MircoM99/electronics/Avionics/components.md

## Components

* Main Board
  * MCU: STM32F411
  * IMU: MPU6050
  * GPS: MS8607
  * TEMP: TM4411, per serbatoio, NBPTCO-176 per altre misurazioni
  * PRS: PT5402 e PT5423
  * SPINTA: FC2311-0000-2000-L
  * PESO SERBATORIO: Cella di carico
  * EEPROM: STM M24M01-DFMN6TP
  * SD: 
  
* BMS
  * 18650 Li Ion
  * 24V: Boost Converter con LM3488
  * 12V: Boost Converter con LM3488
  * 5V: Regolatore lineare con AMS1117CD-5.0
  * 3.3V: Regolatore lineare con AMS1117CD-3.3

* RF 
  * RADIO: LORA SX1278
