MircoM99/electronics/Test Stand/Documents/Components Selection.xlsx

Components Selection
Microcontoller | Qnt | CPU | CPU Speed | RAM | Flash | Power Consumtion | Price (Development Board) | Comments
Arduino Uno | 0 | 8 Bit ATmega328P | 16 Mhz | 2 KB | 32 KB + 1 KB EEPROM | ~ 50 mA | €25.00
Arduino Due | 0 | 32 Bit ATSAM3X8E | 84 Mhz | 96 KB | 512 KB | ~ 100 mA | €40.00
ESP8266 | 0 | 32 Bit Xtensa L106 | 80 - 160 Mhz | 160 KB | ~4 MB (Not on Chip) | 10 ~ 20 mA (Wifi OFF) | €16.00
ESP32 | 3 | 32 Bit Xtensa dual-core LX6 | 160 - 240 Mhz | 520 KB | 4 MB | 30 mA ~ 68 mA | €17.00
Teensy 3.2 | 0 | 32 Bit ARM Cortex M4 | 72 Mhz | 64 KB | 256 KB | ~ 40 mA | €17.00 |  | https://www.pjrc.com/teensy/techspecs.html
Teensy 3.5 | 0 | 32 Bit ARM Cortex M4F | 120 Mhz | 256 KB | 512 KB | ~ 50 mA | €20.50 | SD card holder on board | https://www.pjrc.com/teensy/techspecs.html
Teensy 3.6 | 0 | 32 Bit ARM Cortex M4F | 180 Mhz | 256 KB | 1024 KB | ~ 70 mA | €25.00 | SD card holder on board | https://www.pjrc.com/teensy/techspecs.html
Teensy 4.0 | 0 | 32 Bit ARM Cortex M7 | 600 Mhz | 1 MB | 2 MB | ~ 100 mA | €17.00 |  | https://www.pjrc.com/store/teensy40.html
Teensy 4.1 | 0 | 32 Bit ARM Cortex M7 | 600 Mhz | 1 MB | 8 MB | ~ 100 mA | €22.00 | SD card holder on board | https://www.pjrc.com/store/teensy41.html
Total n. of components | 3
Subprice | €51.00
ADC | Qnt | Bit Resolution | Sampling Speed | Interface | Number of Channel | Operating Voltage | Price (Adafruit) | Comments
ADS1115 | 1 | 16 Bit | 860 Hz | I2C | 4 Channels | 2-5V | €13.00 | 16x Internal PGA, Sampling speed is Hz/N.ofChannels | https://www.adafruit.com/product/1085
ADS1015 | 1 | 12 Bit | 3.3 kHz | I2C | 4 Channels | 2-5V | €8.50 | 16x Internal PGA | https://www.adafruit.com/product/1083
Total n. of components | 2
Subprice | €21.50
Temperature Chip Amplifier | Qnt. | Temperature Sensor | Sampling Speed | Interface | Number of Channel | Operating Voltage | Price (Adafruit) | Comments
MAX31865 | 0 | Platinum RTDs - PT100, PT1000 | ~ 40 Hz | SPI | 1 Channel | 3.3-5V | €12.50 | Internal 15 Bit ADC | https://www.adafruit.com/product/3328
MAX31855 | 0 | Type K - Thermocouple | ~ 14 Hz | SPI | 1 Channel | 3.3-5V | €12.50 | Internal 14 Bit ADC, No linearization or filtering | https://www.adafruit.com/product/269
MAX31850K | 0 | Type K - Thermocouple | ~ 14 Hz | 1-Wire | 1 Channel | 3.3-5V | €12.50 | Internal 14 Bit ADC, No linearization or filtering, 1 -Wire | https://www.adafruit.com/product/1727
MAX31856 | 5 | All Thermocouple | ~ 12.5 Hz | SPI | 1 Channel | 3.3-5V | €15.00 | Internal 19 Bit ADC | https://www.adafruit.com/product/3263
Total n. of components | 5
Subprice | €75.00
Instrument Amplifier | Qnt | Gain Range | CMRR | Noise | Power Consumption | Operating Voltage | ~ Price (RS Components) (Units) | Comments
INA 826 | 0 | 1-1000 | 120 dB (Min) | 0.52 µVpp | 200 µA | ± 3 to 36V | €2.45 | Not avaliable as THT | https://www.ti.com/product/INA826#product-details##params
INA 333 | 0 | 1-1000 | 100 dB (Min) | 1 µVpp | 50 µA | ± 1.8 to 5.5V | €4.45 | Not avaliable as THT | https://www.ti.com/product/INA333#product-details##params
AD 620 | 0 | 1-10000 | 100 dB (Min) | 0.28 µVpp | 1mA | ± 2.3 to 18V | €10.00 | Not single supply?? | https://www.analog.com/en/products/ad620.html#product-overview
INA 131 | 0 | Fixed Gain of 100 | 110 dB (Min) | 0.4 µVpp | 3mA | ± 2.5 to 18V | €10.00 |  | https://www.ti.com/product/INA131#product-details##params
INA 122P | 1 | 5-10000 | 83 dB (Min) | 2 µVpp | 60 µA | ± 2.2 to 36V | €6.00 |  | https://www.ti.com/product/INA122
Total n. of components | 1
Subprice | €6.00
Pressure Sensor | Qnt | Connector | Max Pressure | Output | Fluid Temperature | Operating Voltage | Price (IFM) | Comments
PT5502 | 0 | M12 | 100 bar | 4-20 mA | -40 to 125 °C | 8-32 DC | €109.20 |  | https://www.ifm.com/it/it/product/PT5502
PT5702 | 0 | DEUTSCH (DT04-3P) | 100 bar | 4-20 mA | -40 to 125 °C | 8-32 DC | €109.20 |  | https://www.ifm.com/it/it/product/PT5702
PT5602 | 0 | AMP-Superseal | 100 bar | 4-20 mA | -40 to 125 °C | 8-32 DC | €109.20 |  | https://www.ifm.com/it/it/product/PT5602
PT5002 | 0 | A DIN (EN17501-803-A) | 100 bar | 4-20 mA | -40 to 125 °C | 8-36 DC | €101.30 |  | https://www.ifm.com/it/it/product/PT5002
PU8502 | 0 | M12 | 100 bar | 0.5-4.5V | -40 to 125 °C | 8-32 DC | €109.20 |  | https://www.ifm.com/it/it/product/PU8502
PU8702 | 0 | DEUTSCH (DT04-3P) | 100 bar | 0.5-4.5V | -40 to 125 °C | 8-32 DC | €109.20 |  | https://www.ifm.com/it/it/product/PU8702
PU8523 | 0 | M12 | 60 bar | 0.5-4.5V | -40 to 125 °C | 8-32 DC | €109.20 |  | https://www.ifm.com/it/it/product/PU8523
PT5023 | 0 | A DIN (EN17501-803-A) | 60 bar | 4-20 mA | -40 to 125 °C | 8-36 DC | €101.30 |  | https://www.ifm.com/it/it/product/PT5023
PT5423 | 2 | M12 | 60 bar | 4-20 mA | -40 to 125 °C | 8-36 DC | €101.30 |  | https://www.ifm.com/it/it/product/PT5423
Total n. of components | 2
Subprice | €0.00
Temperature Sensor | Qnt
Thermocouples |  | Sensor Dimension | Operating Temperature |  | Cable Lenght | N of Wires | Price
Termocoppia a fascetta | 0 |  | -100 a 400 | K |  |  | €22.00 |  | https://www.tcdirect.it/Default.aspx?level=2&department_id=180/26
Termocoppia in fibra di vetro | 0 |  | 400 | K |  |  | €10.00 |  | https://www.tcdirect.it/Default.aspx?level=2&department_id=180/20
Termocoppia incollabile | 0 |  | -30 a 220 | K |  |  | €37.00 |  | https://www.tcdirect.it/Default.aspx?level=2&department_id=180/24
Termocoppia adesiva | 0 |  | -50 a 250 | K |  |  | €8.00 |  | https://www.tcdirect.it/Default.aspx?level=2&department_id=180/22
Termocoppia piccola diametro | 0 |  | -100 a 800 | K |  |  | €40.00 |  | https://www.tcdirect.it/Default.aspx?level=2&department_id=200/1
Adafruit Thermocouple | 0 | 2mm x 20mm | 500 °C | K | 1m | 2 Wire | €8.50 |  | https://www.adafruit.com/product/3245
Termocoppia RS Pro | 0 | 5mm x 5mm | 750 °C | K | 2.5m | 2 Wire | €30.00 |  | https://it.rs-online.com/web/p/termocoppie/3342622/
TC Direct 402-718 | 0 | 12mm x 20mm | -250 a 300°C | T | 2m | 2 Wire | €81.00 | Termocoppia classe 1 da incollare | https://www.tcdirect.it/Default.aspx?level=2&department_id=180/25
M12JSS-M3-U-200-E | 5 | 3mm x 200 mm | 520 °C | J | NA |  | €50.00 | With M8x1 Mounting Threads and M12 Connector | https://www.omega.com/en-us/sensors-and-sensing-equipment/temperature/sensors/temperature-probes/probes-with-integral-connector/p/M12probes
Pt100
Adafruit Platinum RTD | 0 | 4mm x 30mm | -200 a 550 °C |  | 1 m | 3 Wire | €10.00 | ±0.5° C accuracy (To 85°C) | https://www.adafruit.com/product/3290
IFM TS2451 | 0 | 6mm x 50mm | -100 a 600 °C |  | 2m |  | €90.00 | M12 Connector | https://www.ifm.com/it/it/product/TS2451
Total n. of components | 5
Subprice | €250.00 |  |  |  |  |  |  |  | https://it.omega.com/pptst/PR-10.html
Cable Options | Qnt | Type of Cable | Connector | Wires | Lenght |  | Price
Omega M12 Thermocouple Cable | 1 | Stripped Thermocouple Wire | M12 | 2 |  |  | €40.00 | Compensated Thermocouple Cable, Sockets and Pins | https://it.omega.com/pptst/M12CM.html
EVS024 | 1 | Right Angle M12 Cable | M12 | 4 | 5m |  | €14.50 |  | https://www.ifm.com/it/it/product/EVS024
Total n. of components | 2
Subprice | €54.50
Load Cell | Qnt | Cell Type | Capacity |  | Rated Output | Excitation Voltage | Price | Comments
Cella di carico Tedea Huntleigh | 0 | Compressione - Single point | 100 kg |  | 2mV/V | 15 V (Max) | €156.00 |  | https://it.rs-online.com/web/p/celle-di-carico/4438229/
Cella di carico Phidgets | 0 | Compressione - S Type | 100 kg |  | NA | 5-18V | €68.00 | https://www.phidgets.com/?tier=3&catid=9&pcid=7&prodid=229 | https://www.robot-italy.com/it/3138-s-type-load-cell-0-100kg-czl301c.html
Cella di carico TE connectivity | 1 | Compressione - Button | 250 lb |  | 20mV/V | 2-10V | €114.87 |  | https://www.digikey.it/product-detail/it/te-connectivity-measurement-specialties/FC2311-0000-0250-L/MSP6952-ND/809398
Total n. of components | 1
Subprice | €114.87
Barometer/Altimeter | Qnt | Breakout Type | Interface |  | Operating Voltage |  | Price
BMP 280 | 1 | Bosch BMP280 Adafruit | I2C or SPI |  | 3.3/5 V |  | €10.00 |  | https://www.adafruit.com/product/2651
Total n. of components | 1
Subprice | €10.00
Total n. of Components | 22
Total Price | €582.87
