MircoM99/electronics/Test Stand/Documents/README.md

# Documentation links

Qui sono disponibili i link alla documentazione più rilevante riguardo i componenti e i sensori selezionati.  
Nella cartella `\Datasheet PDF` sono presenti i principali datasheet in formato PDF.

## Adafruit HUZZAH32
- [Adafruit Shop](https://www.adafruit.com/product/3405)
- [Adafruit Overview](https://learn.adafruit.com/adafruit-huzzah32-esp32-feather)
- [ESP32 Datasheet](https://www.espressif.com/sites/default/files/documentation/esp32_datasheet_en.pdf)
- [ESP32 WROOM32 Datasheet](https://www.espressif.com/sites/default/files/documentation/esp32-wroom-32_datasheet_en.pdf)
- [ESP32 Technical Manual](https://espressif.com/sites/default/files/documentation/esp32_technical_reference_manual_en.pdf)

  - [Adafruit HUZZAH32 Schematics](https://cdn-learn.adafruit.com/assets/assets/000/041/630/original/feather_schem.png?1494449413)
  - [Adafruit HUZZAH32 PCB Layout](https://cdn-learn.adafruit.com/assets/assets/000/041/629/original/feather_fabprint.png?1494449394)

## Adafruit ADS1115 - ADS1015
- [Adafruit ADS1115 Shop](https://www.adafruit.com/product/1085)
- [Adafruit ADS1015 Shop](https://www.adafruit.com/product/1083)
- [Adafruit ADS1115/ADS1015 Overview](https://learn.adafruit.com/adafruit-4-channel-adc-breakouts/overview)
- [ADS1115 Datasheet](https://cdn-shop.adafruit.com/datasheets/ads1115.pdf)
- [ADS1015 Datasheet](https://cdn-shop.adafruit.com/datasheets/ads1015.pdf)

  - [ADS1115/ADS1015 Schematics](https://cdn-learn.adafruit.com/assets/assets/000/036/145/original/sensors_schem.png?1475541078)
  - [ADS1115/ADS1015 PCB Layout](https://cdn-learn.adafruit.com/assets/assets/000/036/146/original/sensors_fabprint.png?1475541096)
  
## Adafruit MAX31856
- [Adafruit Shop](https://www.adafruit.com/product/3263)
- [Adafruit Overview](https://learn.adafruit.com/adafruit-max31856-thermocouple-amplifier)
- [MAX31856 Datasheet](https://cdn-learn.adafruit.com/assets/assets/000/035/948/original/MAX31856.pdf)

  - [Adafruit MAX31856 Schematics](https://cdn-learn.adafruit.com/assets/assets/000/035/946/original/sensors_schem.png?1474583748)
  - [Adafruit MAX31856 PCB Layout](https://cdn-learn.adafruit.com/assets/assets/000/035/947/original/sensors_fab.png?1474584073)
  
## Adafruit MicroSD Breakout
- [Adafruit Shop](https://www.adafruit.com/product/254)
- [Adafruit Overview](https://learn.adafruit.com/adafruit-micro-sd-breakout-board-card-tutorial)

  - [Adafruit MicroSD Breakout Schematic](https://cdn-learn.adafruit.com/assets/assets/000/035/635/original/adafruit_products_schem.png?1473451805)
  - [Adafruit MicroSD Breakout PCB Layout](https://cdn-learn.adafruit.com/assets/assets/000/035/634/original/adafruit_products_fabprint.png?1473451788)
  
## INA 122
- [INA 122 Overview](https://www.ti.com/product/INA122)
- [INA 122 Datasheet](https://www.ti.com/lit/ds/symlink/ina122.pdf)

## IFM PT5423 Pressure Sensor
- [IFM PT5423 Shop](https://www.ifm.com/it/it/product/PT5423)
- [IFM PT5423 Datasheet](https://www.ifm.com/restservices/it/it/assets/c3VwcGxpZXJzL2lmbS9kb2N1bWVudHMvcHJvZHVjdC9QVDU0MjMtMDEvZGF0ZW5ibGFldHRlci9QVDU0MjMtMDFfSVQtSVQucGRm)

## Omega M12JSS-M3-U-200-E Thermocouple
- [Omega M12 Thermocouples Shop](https://it.omega.com/pptst/M12PROBES.html)
- [Omega M12 Thermocouples Datasheet](https://it.omega.com/temperature/pdf/M12PROBES.pdf)
