MircoM99/electronics/Test Stand/Hardware/Test Stand PCB/README.md

# \Hardware

## Cartella di progetto
In questa cartella è contenuto lo schema elettrico della PCB in tutte le sue parti che verrà utilizzato per montare i circuiti nella fase di test. Esiste anche una cartella "OldVersion" che contiene
il vecchio proggetto implementato su KiCad.
