MircoM99/electronics/Test Stand/Hardware/Test Stand PCB/OldVersion/README.md

# \Hardware

## Cartella di progetto
- `\Test Stand PCB`
  - `\Test Stand PCB.pro` - File di progetto Kicad
  - `\Test Stand PCB.sch` - Schematic file
  - `\Test Stand PCB.kicad_pcb` - PCB layout file
  - `\Breakout_Test_Stand_Library.lib` - Symbol library
  - `\Test Stand PCB Breakout.pretty` - Footprint library
  
## PDF Schematic
- `Test Stand.pdf`                   
 
## Schematic Template File  
- `Thrust Schematic Template.kicad_wks`  

Template file per il cartiglio  
Per completare la tavola andare su **"Edit Page Layout"** ed inserire nei rispettivi campi:

  - `Company` = Università degli Studi di Padova
  - `Comment 1` = Nome dell'autore
  - `Comment 2` = Thrust Team

<p align="center">
  
   
</p>
