MircoM99/electronics/Test Stand/Figures/TSPCB_all.png

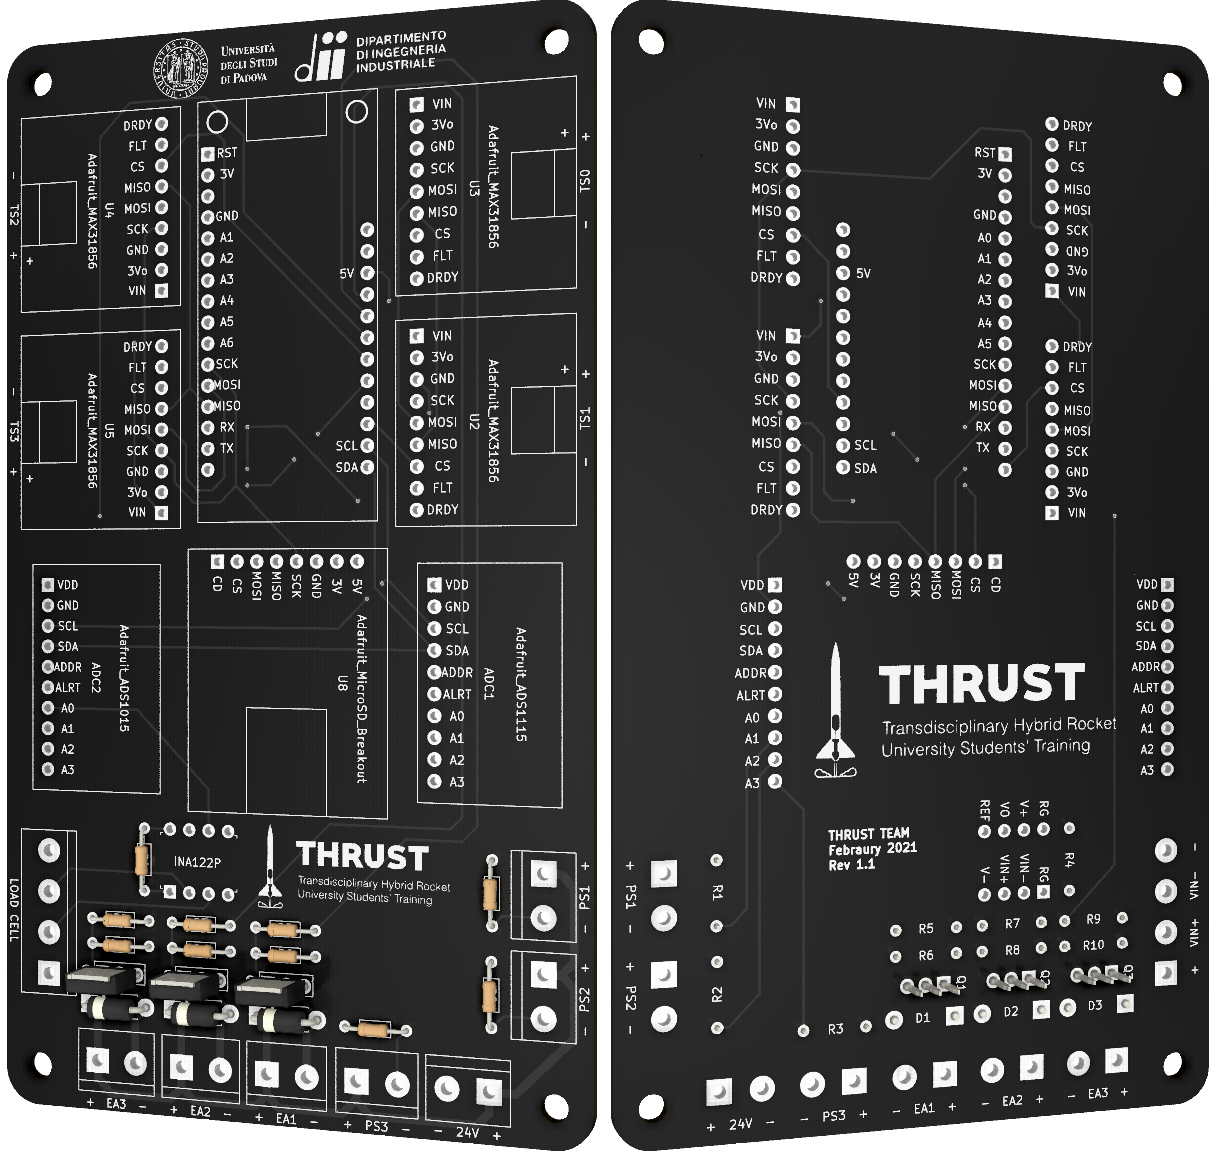
Test Stand/Figures/TSPCB_all.png
