MircoM99/electronics/Test Stand/Figures/TSPCB_Back.PNG

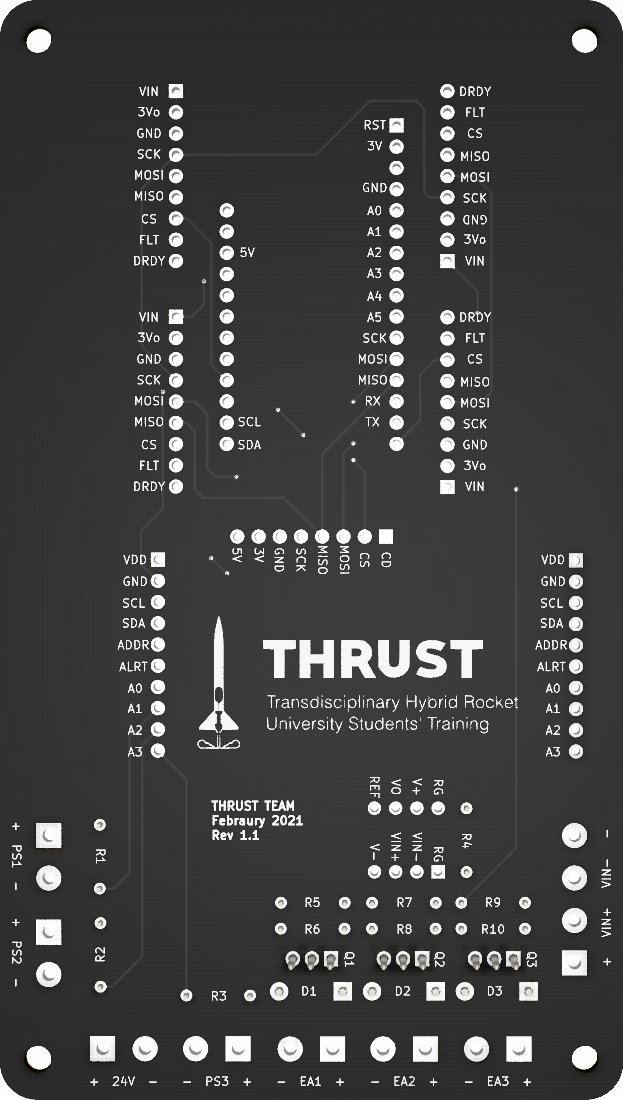
Test Stand/Figures/TSPCB_Back.PNG
