MircoM99/electronics/Test Stand/Figures/TSPCB_Front.PNG

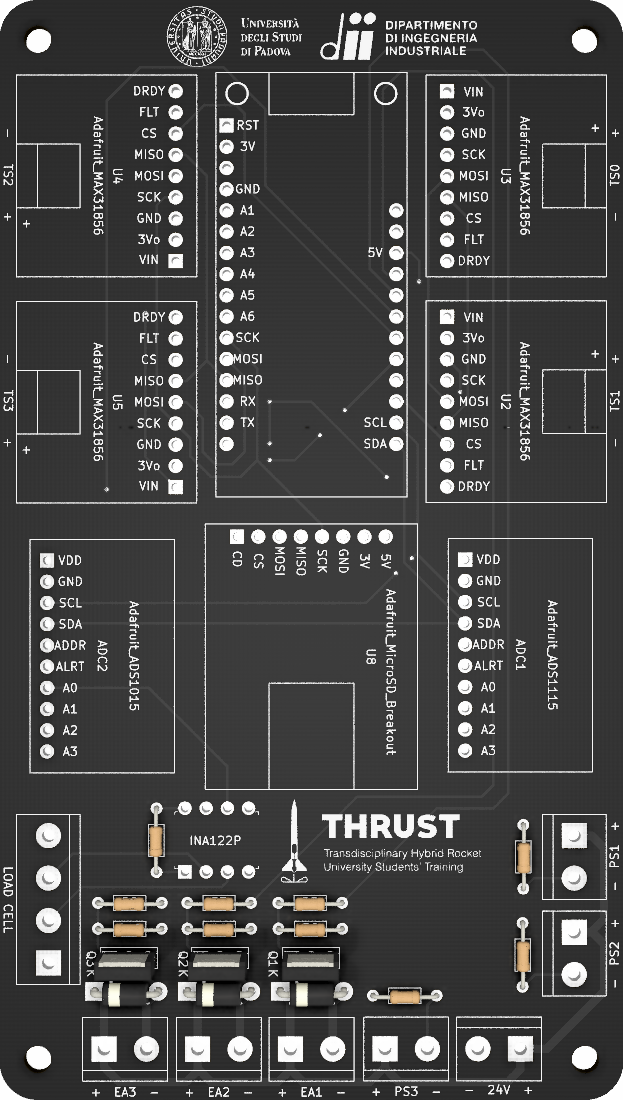
Test Stand/Figures/TSPCB_Front.PNG
