MircoM99/electronics/Test Stand/Figures/actuator.pdf

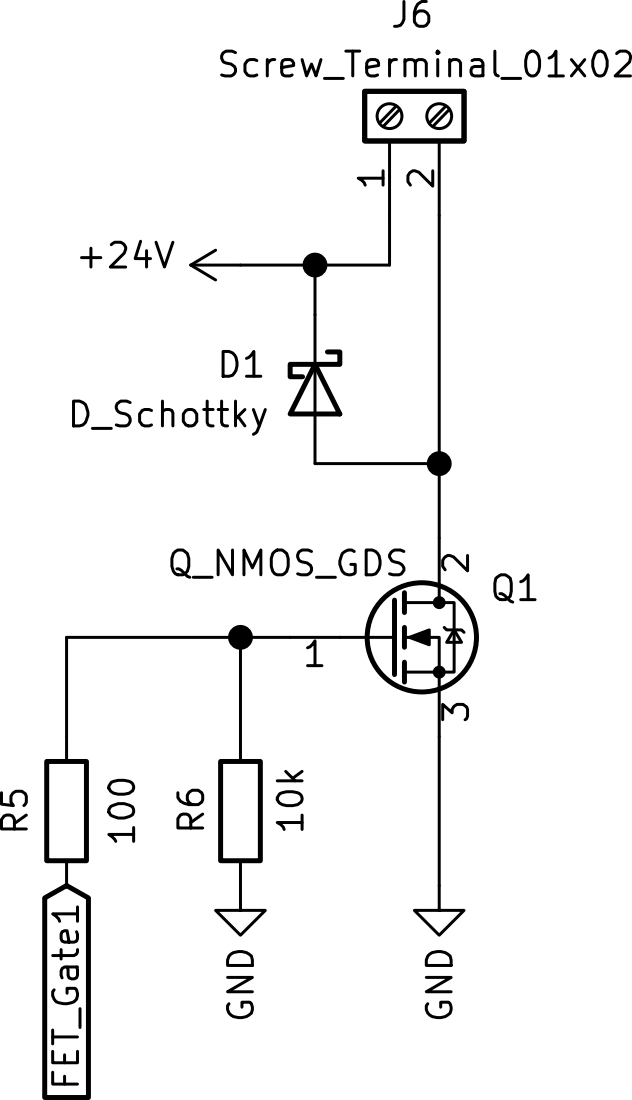
[picture p19: page 1]
