MircoM99/electronics/Test Stand/Figures/schema-1-2-3.pdf

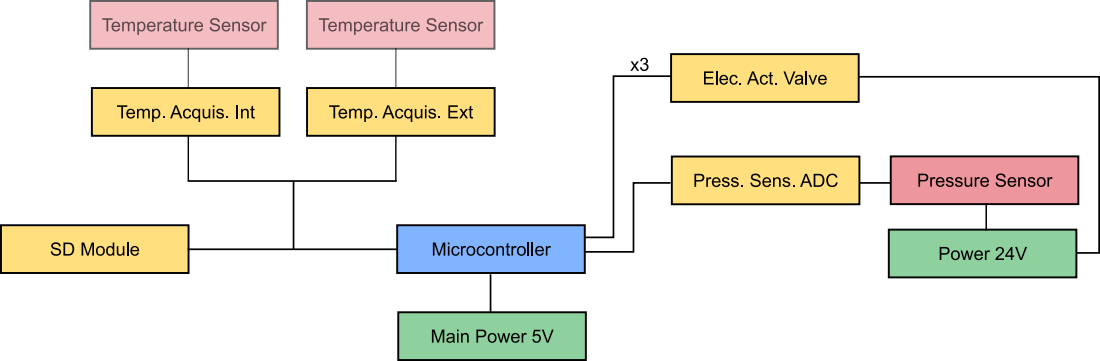
[picture p20: page 1]
