MircoM99/electronics/Test Stand/Figures/pid.pdf

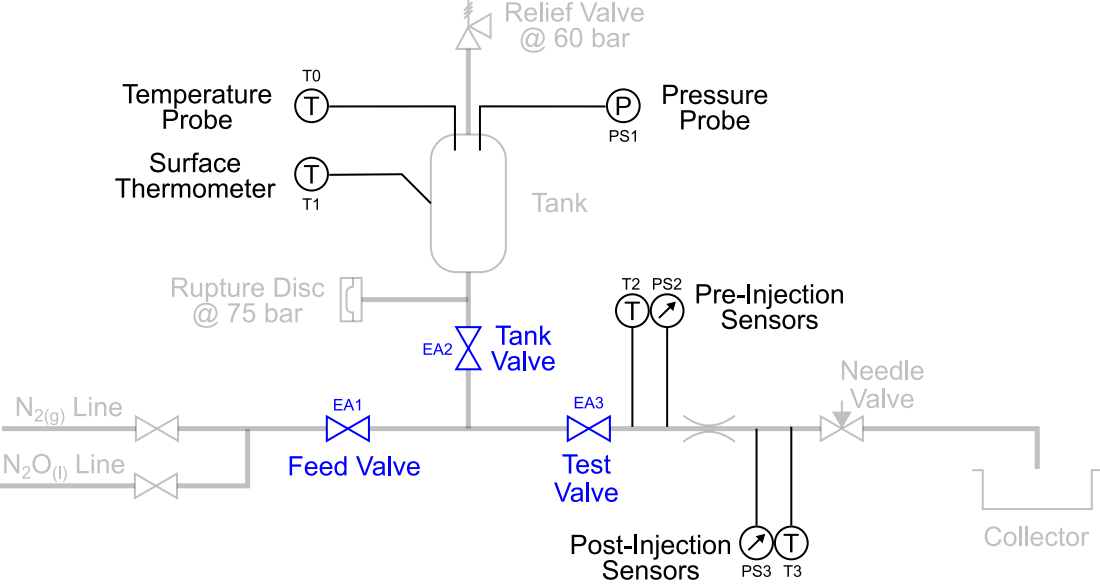
[picture p21: page 1]
