MircoM99/electronics/Test Stand/Figures/schema-generale.pdf

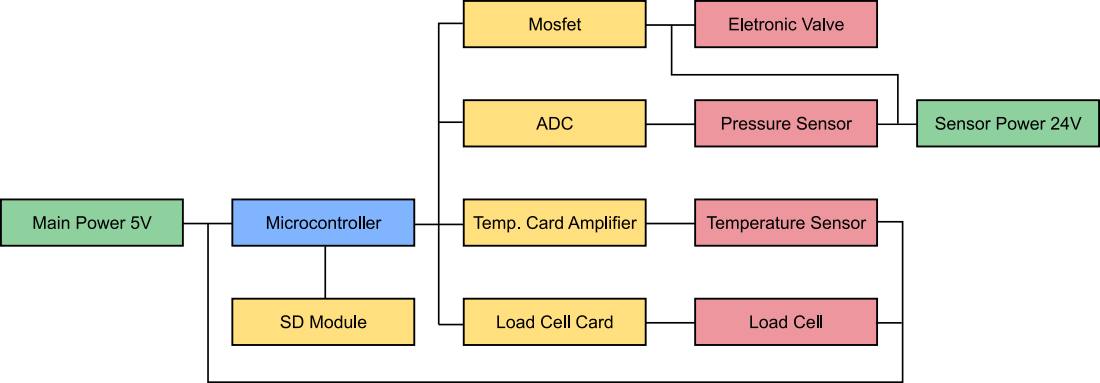
[picture p22: page 1]
