MircoM99/electronics/Test Stand/Documents/Test Stand PCB_(OldVersion).pdf

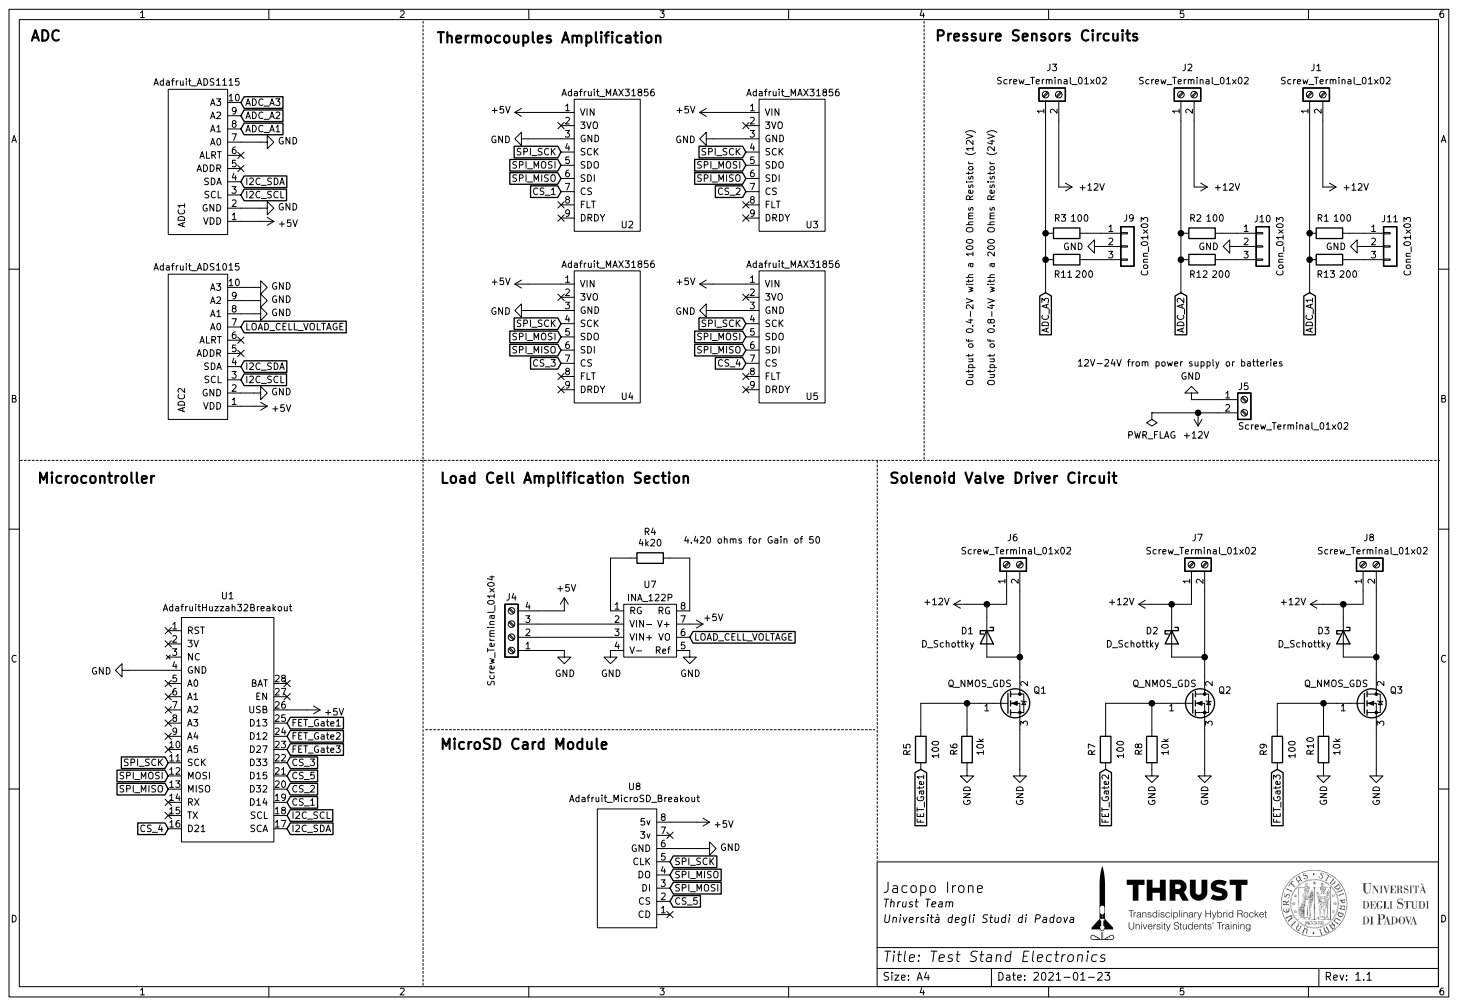
[picture p23: page 1]

2 3 Q1 Q_NMOS_GDS R5 100 +5V RST 1 A5 10 SCK 11 MOSI 12 MISO 13 RX 14 TX 15 D21 16 SCA 17 SCL 18 D14 19

2 3 Q2 Q_NMOS_GDS D2 D_Schottky CD 1 CS 2 DI 3 DO 4 CLK 5 GND 6

Università degli Studi di Padova
