MircoM99/electronics/Test Stand/Documents/Test 1-2-3 Schematic_(OldVersion).pdf

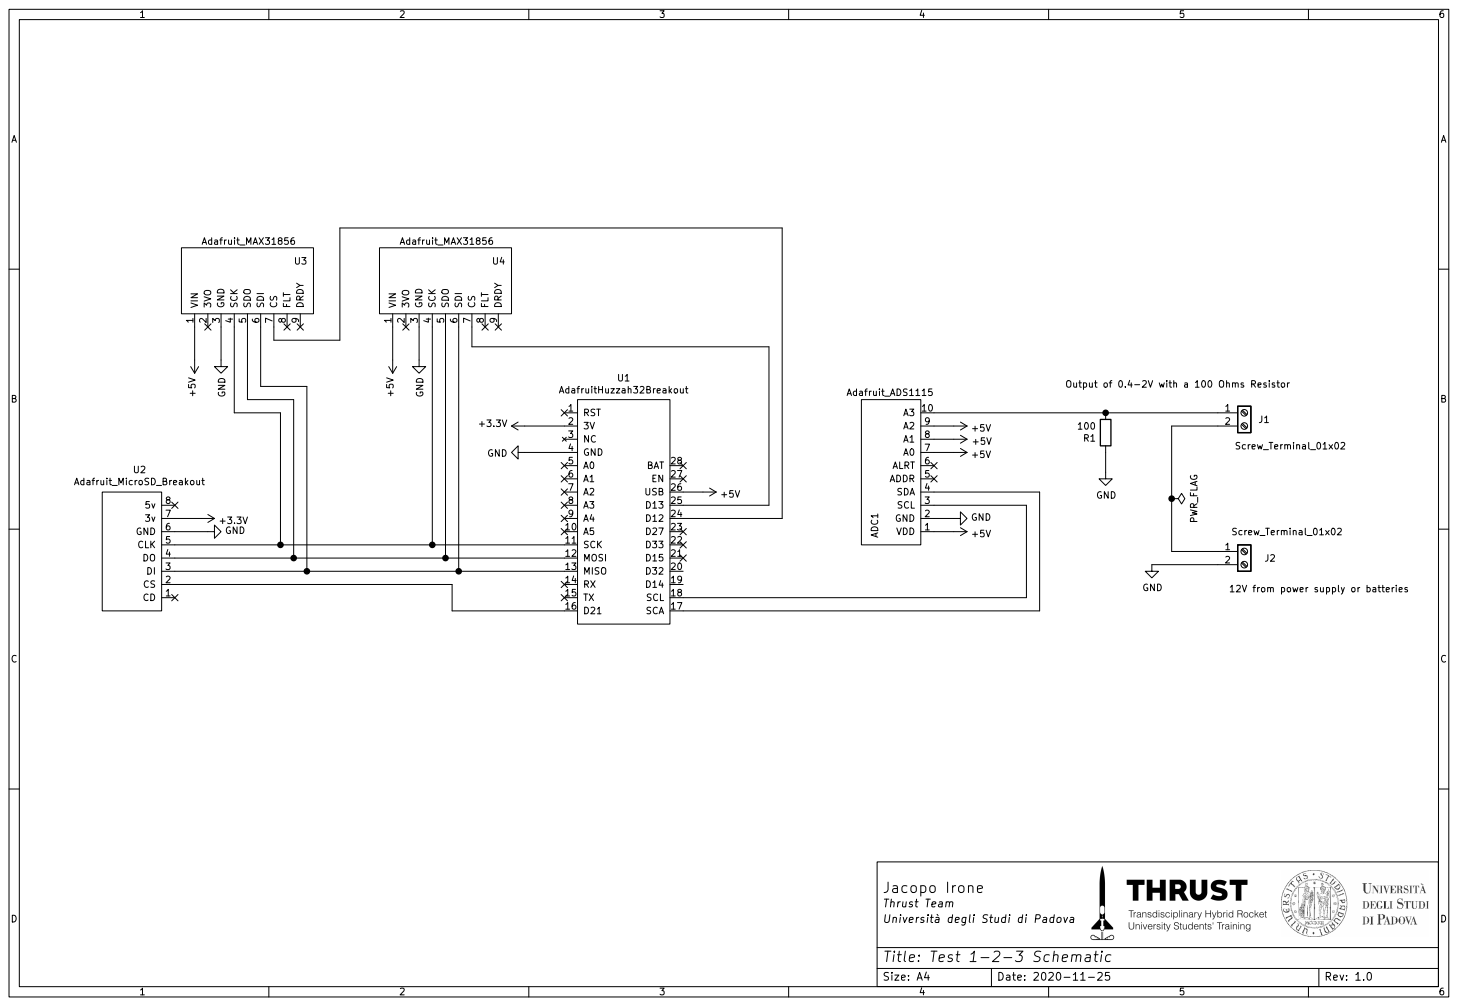
[picture p24: page 1]

9 U4 Adafruit_MAX31856 RST 1 A5 10 SCK 11 MOSI 12 MISO 13 RX 14 TX 15 D21 16 SCA 17 SCL 18 D14 19

Output of 0.4-2V with a 100 Ohms Resistor

12V from power supply or batteries

Jacopo Irone
Thrust Team
Università degli Studi di Padova
