MircoM99/electronics/Test Stand/Hardware/Test Stand PCB/OldVersion/Test Stand PCB.pdf

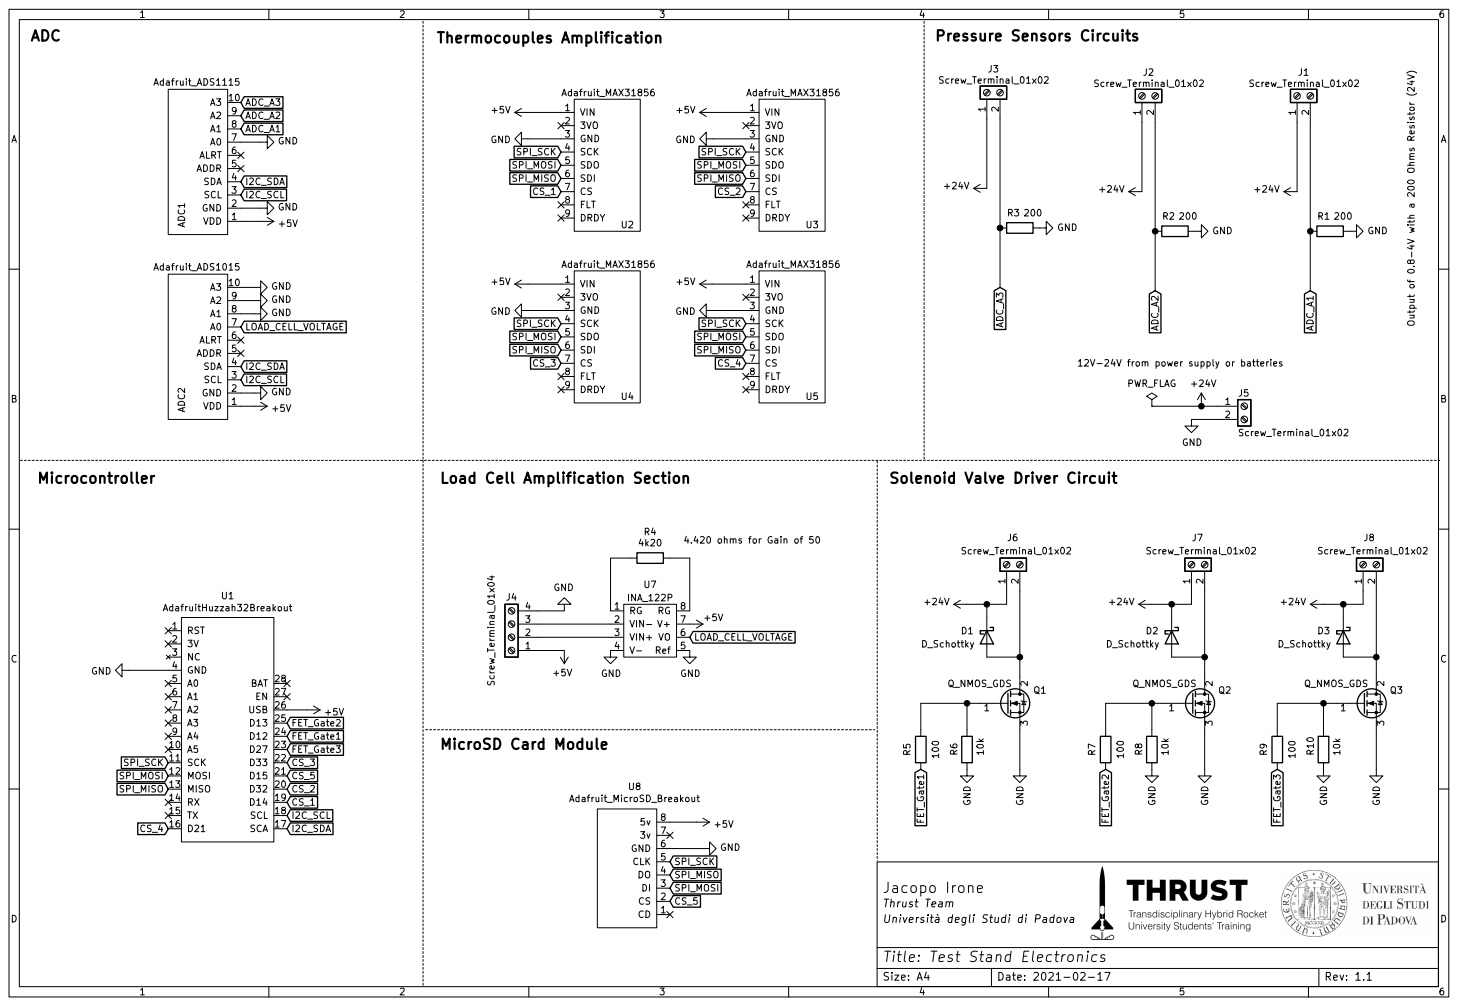
[picture p25: page 1]

12V-24V from power supply or batteries

4.420 ohms for Gain of 50 Load Cell Amplification Section

Jacopo Irone
Thrust Team
Università degli Studi di Padova
