MircoM99/electronics/Test Stand/Hardware/Test Stand PCB/OldVersion/OldVersionOnKiCad/Test Stand PCB.kicad_pcb

## KiCad design Test Stand/Hardware/Test Stand PCB/OldVersion/OldVersionOnKiCad/Test Stand PCB.kicad_pcb (2021-03-13, an earlier design)

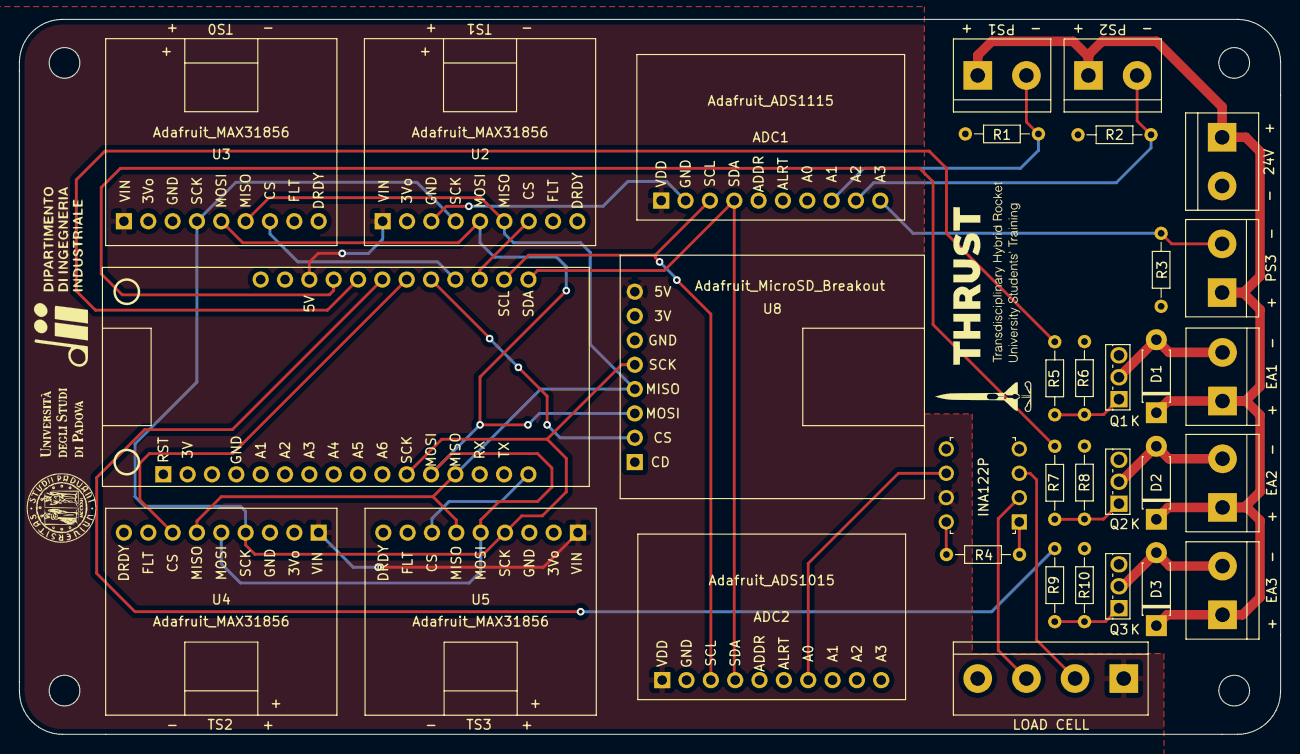
[picture p26: board Test Stand PCB.kicad_pcb from above]

Board: 2 copper layers, 131.6 x 74.6 mm, 33 parts (0 on the bottom side), 30 nets.

Parts:
+  EA1  -, +  EA2  -, +  EA3  -: Screw_Terminal_01x02; TerminalBlock_bornier-2_P5.08mm
+  PS3  -: Screw_Terminal_01x02; TerminalBlock_bornier-2_P5.08mm
-  24V  +: Screw_Terminal_01x02; TerminalBlock_bornier-2_P5.08mm
-  PS1  +, -  PS2  +: Screw_Terminal_01x02; TerminalBlock_bornier-2_P5.08mm
ADC1: Adafruit_ADS1115
ADC2: Adafruit_ADS1015
D1, D2, D3: D_Schottky; D_DO-41_SOD81_P7.62mm_Horizontal
LOAD CELL: Screw_Terminal_01x04; TerminalBlock_bornier-4_P5.08mm
Q1, Q2, Q3: Q_NMOS_GDS; TO-251-3_Vertical
R1, R2, R3: 200; R_Axial_DIN0204_L3.6mm_D1.6mm_P7.62mm_Horizontal
R4: 4k20; R_Axial_DIN0204_L3.6mm_D1.6mm_P7.62mm_Horizontal
R5, R7, R9: 100; R_Axial_DIN0204_L3.6mm_D1.6mm_P7.62mm_Horizontal
R6, R8, R10: 10k; R_Axial_DIN0204_L3.6mm_D1.6mm_P7.62mm_Horizontal
U1: AdafruitHuzzah32Breakout; Adafruit_Huzzah32
U2, U3, U4, U5: Adafruit_MAX31856
U7: INA_122P
U8: Adafruit_MicroSD_Breakout; Adafruit_MicroSD

Connections:
+5V: ADC1.1, ADC2.1, LOAD CELL.1, U1.26, U2.1, U3.1, U4.1, U5.1, U7.7, U8.8
+24V: + EA1 -.1, + EA2 -.1, + EA3 -.1, + PS3 -.1, - 24V +.1, - PS1 +.1, - PS2 +.1, D1.1, D2.1, D3.1
ADC_A1: - PS1 +.2, ADC1.8, R1.2
ADC_A2: - PS2 +.2, ADC1.9, R2.2
ADC_A3: + PS3 -.2, ADC1.10, R3.2
CS_1: U1.19, U2.7
CS_2: U1.20, U3.7
CS_3: U1.22, U4.7
CS_4: U1.16, U5.7
CS_5: U1.21, U8.2
FET_Gate1: R5.1, U1.24
FET_Gate2: R7.1, U1.25
FET_Gate3: R9.1, U1.23
GND: - 24V +.2, ADC1.2, ADC1.7, ADC2.2, ADC2.8, ADC2.9, ADC2.10, LOAD CELL.4, Q1.3, Q2.3, Q3.3, R1.1, R2.1, R3.1, R6.2, R8.2, R10.2, U1.4, U2.3, U3.3, U4.3, U5.3, U7.4, U7.5, U8.6
I2C_SCL: ADC1.3, ADC2.3, U1.18
I2C_SDA: ADC1.4, ADC2.4, U1.17
LOAD_CELL_VOLTAGE: ADC2.7, U7.6
unnamed: + EA1 -.2, D1.2, Q1.2
unnamed: + EA2 -.2, D2.2, Q2.2
unnamed: + EA3 -.2, D3.2, Q3.2
unnamed: LOAD CELL.2, U7.3
unnamed: LOAD CELL.3, U7.2
unnamed: Q1.1, R5.2, R6.1
unnamed: Q2.1, R7.2, R8.1
unnamed: Q3.1, R9.2, R10.1
unnamed: R4.1, U7.8
unnamed: R4.2, U7.1
SPI_MISO: U1.13, U2.6, U3.6, U4.6, U5.6, U8.4
SPI_MOSI: U1.12, U2.5, U3.5, U4.5, U5.5, U8.3
SPI_SCK: U1.11, U2.4, U3.4, U4.4, U5.4, U8.5
