MircoM99/electronics/Test Stand/Software/TestThrustDir/TestThrust.ioc

Mcu.UserName=STM32F411RETx
PA0-WKUP.Signal=ADCx_IN0
PA1.Signal=ADCx_IN1
PA13.GPIO_Label=TMS
PA13.Signal=SYS_JTMS-SWDIO
PA14.GPIO_Label=TCK
PA14.Signal=SYS_JTCK-SWCLK
PA2.GPIO_Label=USART_TX
PA2.Signal=USART2_TX
PA3.GPIO_Label=USART_RX
PA3.Signal=USART2_RX
PA4.Signal=ADCx_IN4
PA5.GPIO_Label=LD2 [Green Led]
PA5.Signal=GPIO_Output
PA6.Signal=ADCx_IN6
PA7.Signal=ADCx_IN7
PB0.Signal=ADCx_IN8
PB1.Signal=ADCx_IN9
PB3.GPIO_Label=SWO
PB3.Signal=SYS_JTDO-SWO
PC0.Signal=ADCx_IN10
PC1.Signal=ADCx_IN11
PC13-ANTI_TAMP.GPIO_Label=B1 [Blue PushButton]
PC13-ANTI_TAMP.Signal=GPXTI13
PC14-OSC32_IN.Signal=RCC_OSC32_IN
PC15-OSC32_OUT.Signal=RCC_OSC32_OUT
PC2.Signal=ADCx_IN12
