MircoM99/electronics/(commit log)

2020-11-17 Upload di documentazione e design file per il PCB
    [Components Selection.xlsx, Test Bench PCB.kicad_pcb, Test Bench PCB.sch]
2020-11-17 Updated Component selection spreadsheet and PCB schematics
    [Components Selection.xlsx, Test Bench PCB.sch]
2020-11-18 Updated PCB schematic pdf
2020-11-18 Changed the repository structure
    [Components Selection.xlsx, Test Bench PCB.kicad_pcb, Test Bench PCB.sch]
2020-11-23 Update file names and upload of the schematic template
    [Components Selection.xlsx, Test Stand PCB.kicad_pcb, Test Stand PCB.sch]
2020-11-24 Aggiunta bozza campagna di test
    Posizione del documento provvisoria, metto in electronics per comodità per Jacopo
2020-11-26 Updated Test schematic and PCB Design
    [Components Selection.xlsx, Test 1-2-3 Schematic.sch, Test Stand PCB.kicad_pcb, Test Stand PCB.sch]
2020-12-05 Added gerber file for manufacturing of Test Stand PCB v1.0
    [Test Stand PCB-B_Cu.gbr, Test Stand PCB-B_Mask.gbr, Test Stand PCB-B_SilkS.gbr, Test Stand PCB-Edge_Cuts.gbr, Test Stand PCB-F_Cu.gbr, Test Stand PCB-F_Mask.gbr, Test Stand PCB-F_Paste.gbr, Test Stand PCB-F_SilkS.gbr]
2020-12-05 Create Dimensionamento Preliminare Elettronica di volo.md
2020-12-05 Update Dimensionamento Preliminare Elettronica di volo.md
2020-12-31 Updated Schematic PDF
    [Test Stand PCB.sch]
2020-12-31 Updated PDF schematics
2021-01-01 Create Requisiti di sistema.txt
2021-01-01 Create Requisiti di Sistema.md
2021-02-19 aggiunta pid con evidenziati sensori e elettrovalvole
2021-03-02 Uploading of the Rev1.1 Board
    Rev1.1 Board, changes:
    - Added 2 more Electronic actuator circuit drivers
    - Changed screw terminal layout
    - Added Front and Back Silckscreen
    - Improved Layout
    - Changed resistor footprint
    - Changed Sensor Power from 12V to 24V
    [Test Stand PCB.kicad_pcb, Test Stand PCB.sch]
2021-03-13 Added Mounting Holes
    [Test Stand PCB.kicad_pcb]
2021-03-13 Upload PCB images and Updated Dimensionamento elettronica preliminare
2021-03-13 Cut PCB Images
2021-03-31 Update Requisiti di Sistema.md
2022-08-11 Lista cose da comprare
    Modifica dei componenti e inserimento di una bozza della lista delle cose da comprare
    [ListaCoseDaComprare.xlsx]
2022-12-18 Aggiornamento lavori 2022
    Sono stati aggiornati la maggior parte dei files con le modifiche adottate nel 2022. La sezione Test Stand contiene ancora del vecchio materiale che verrà sostituito non appena disponibile.
    [ListaCoseDaComprare.xlsx, Test 1-2-3 Schematic.sch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]
2022-12-23 STM32 Software
    Inserimento del progetto su STM32CubeIDE per il software da usare nella fase di test
2022-12-28 Programma per i test
    Sistema di acquisizione dati con STM32F411 su Nucleo board F411RE
